markvin/Thermst/README.md

# Thermst

A hardware and software complex for controlling a heating element operating from a 230 V AC network.
