markvin/Thermst/hardware/kicad/thermst/thermst.kicad_pcb

## KiCad design hardware/kicad/thermst/thermst.kicad_pcb (2023-11-10)

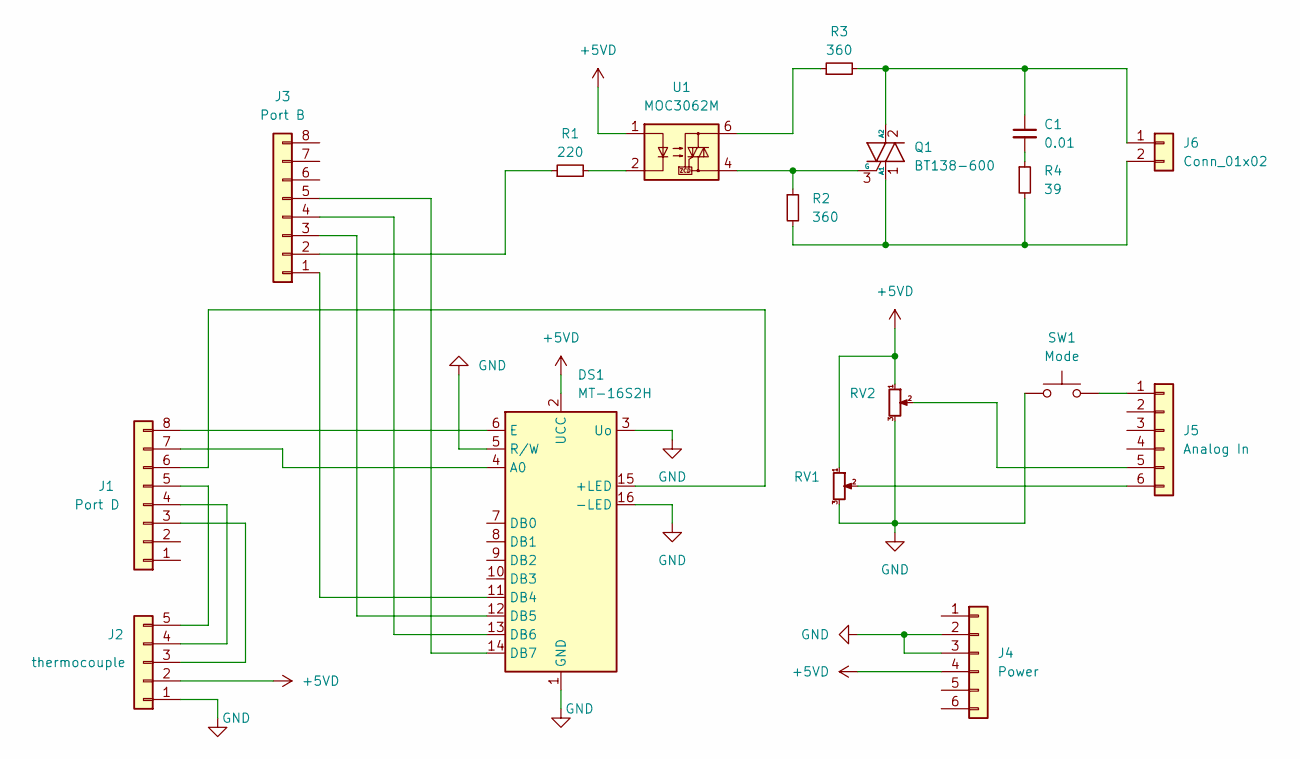
[picture p16: schematic thermst.kicad_sch]

Parts:
C1: 0.01; C_Rect_L13.0mm_W4.0mm_P10.00mm_FKS3_FKP3_MKS4
DS1: MT-16S2H; MT16S2H
J1: Port D; PinHeader_1x08_P2.54mm_Vertical
J2: thermocouple; PinHeader_1x05_P2.54mm_Horizontal
J3: Port B; PinHeader_1x08_P2.54mm_Vertical
J4: Power; PinHeader_1x06_P2.54mm_Vertical
J5: Analog In; PinHeader_1x06_P2.54mm_Vertical
J6: Conn_01x02; SolderWire-0.75sqmm_1x02_P4.8mm_D1.25mm_OD2.3mm
Q1: BT138-600; TO-220-3_Vertical
R1: 220; R_Axial_DIN0309_L9.0mm_D3.2mm_P12.70mm_Horizontal
R2, R3: 360; R_Axial_DIN0414_L11.9mm_D4.5mm_P15.24mm_Horizontal
R4: 39; R_Axial_DIN0414_L11.9mm_D4.5mm_P15.24mm_Horizontal
RV1: Temperature; Potentiometer_ACP_CA9-V10_Vertical
RV2: Power; Potentiometer_ACP_CA9-V10_Vertical
SW1: Mode; SW_PUSH_6mm_H13mm
U1: MOC3062M; DIP-6_W7.62mm

Connections:
+5VD: DS1.2 (UCC), J2.2, J4.4, RV1.1, RV2.1, U1.1
GND: DS1.1 (GND), DS1.3 (Uo), DS1.5 (R/W), DS1.16 (-LED), J2.1, J4.2, J4.3, RV1.3, RV2.3, SW1.1
unnamed: C1.2, R4.1
unnamed: DS1.15 (+LED), J1.6
unnamed: DS1.4 (A0), J1.7
unnamed: DS1.11 (DB4), J3.1
unnamed: DS1.12 (DB5), J3.3
unnamed: DS1.13 (DB6), J3.4
unnamed: DS1.14 (DB7), J3.5
unnamed: DS1.6 (E), J1.8
unnamed: J1.3, J2.3
unnamed: J1.4, J2.4
unnamed: J1.5, J2.5
unnamed: J3.2, R1.1
unnamed: J5.1, SW1.2
unnamed: J5.5, RV2.2
unnamed: J5.6, RV1.2
unnamed: C1.1, J6.1, Q1.2 (A2), R3.2
unnamed: J6.2, Q1.1 (A1), R2.2, R4.2
unnamed: Q1.3 (G), R2.1, U1.4
unnamed: R1.2, U1.2
unnamed: R3.1, U1.6

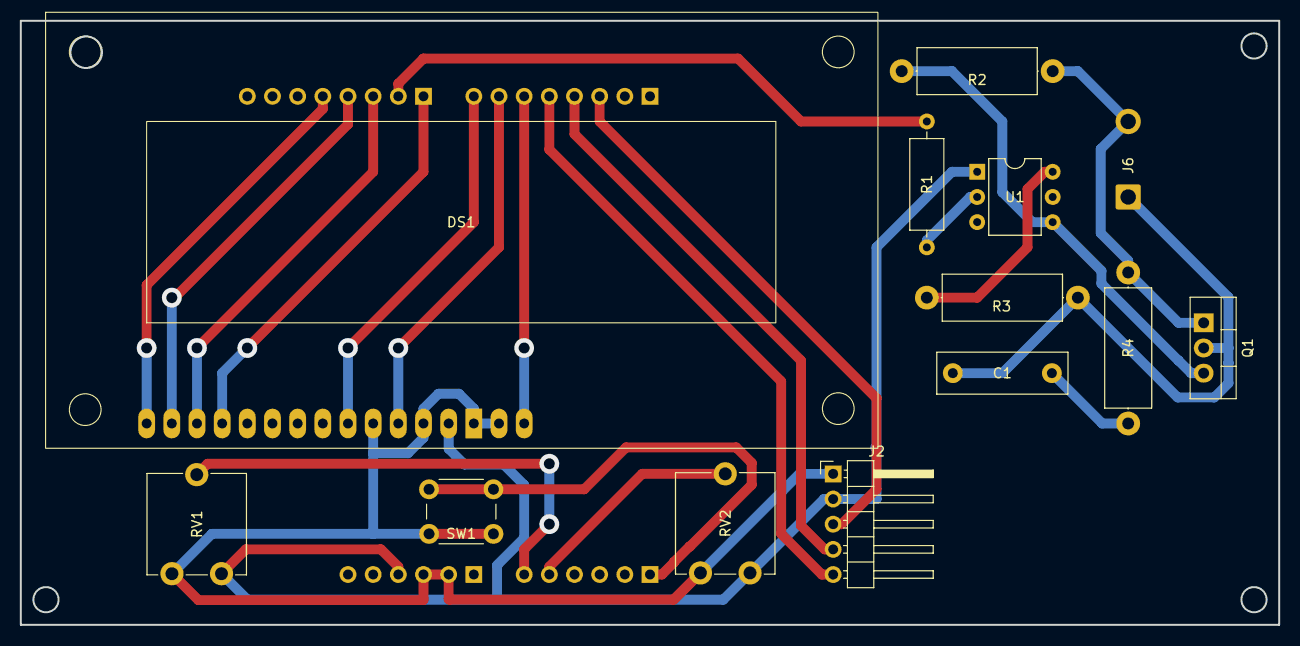
[picture p17: board thermst.kicad_pcb from above]

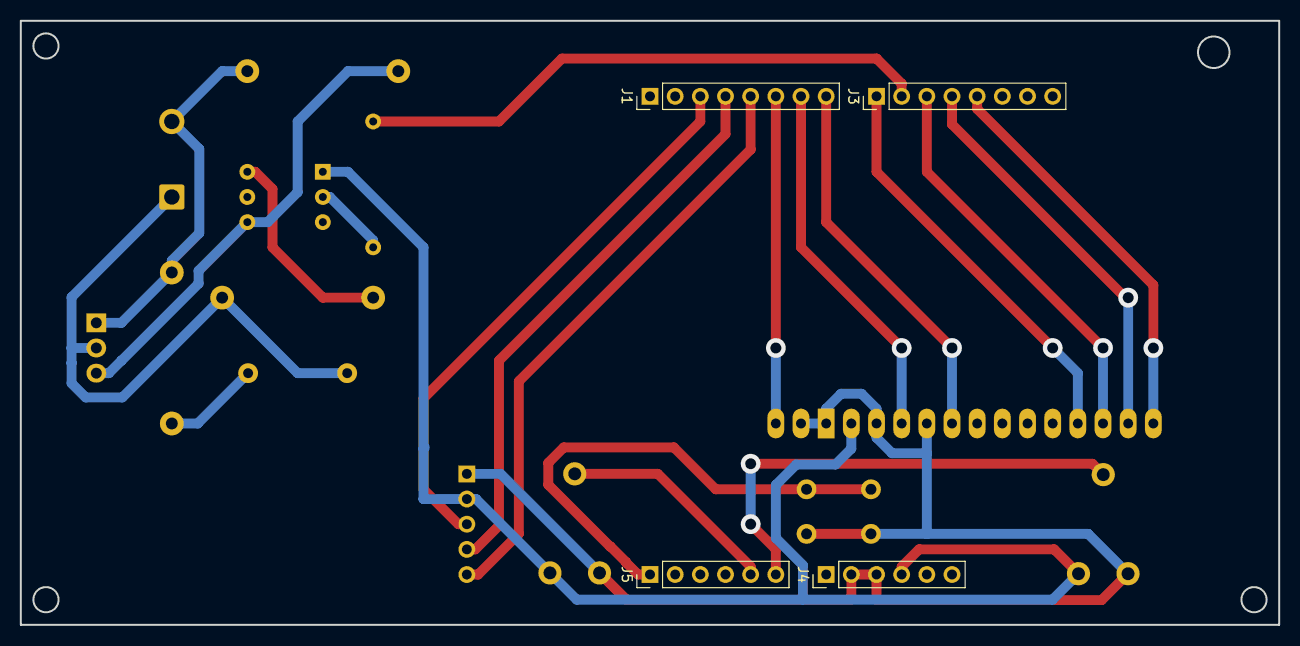
[picture p18: board thermst.kicad_pcb from below]

Board: 2 copper layers, 127.0 x 61.0 mm, 17 parts (4 on the bottom side), 22 nets.
