markvin/Thermst/(commit log)

2023-11-03 Add hardware (kicad) content
    [thermst.kicad_pcb, thermst.kicad_sch]
2023-11-10 Fix bugs after hardware assembled
    [thermst.kicad_pcb, thermst.kicad_sch]
2023-11-12 Remove kicad backups
